zkity/sweetHome/docs/reference/raspberrypi.md

# RaspBerry Pi4

## GPIO

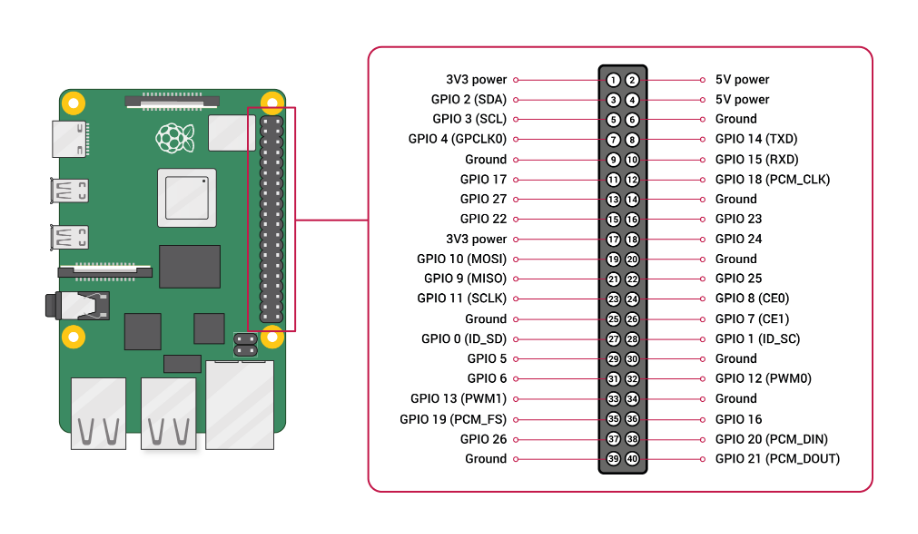
[picture p20: docs/reference/imgs/raspberrypi/2020-05-14-17-41-08.png]


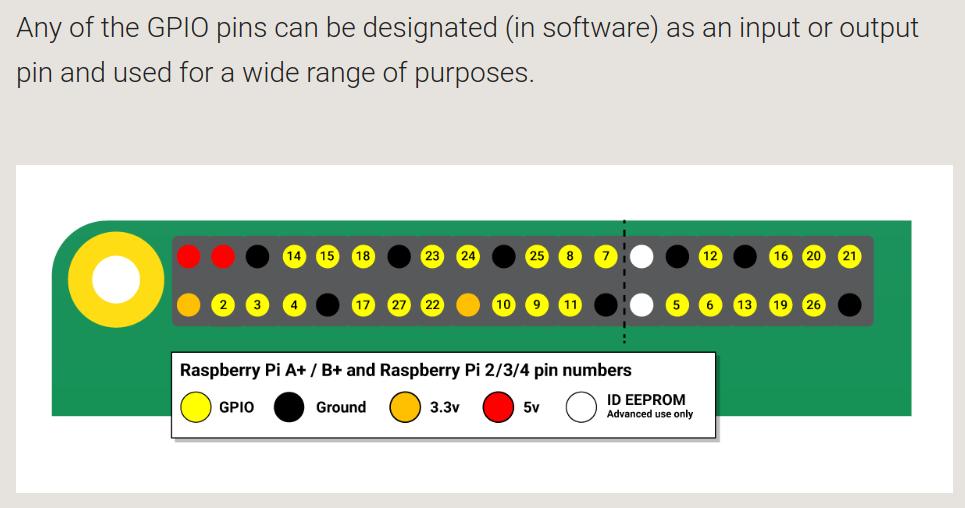
[picture p21: docs/reference/imgs/raspberrypi/2020-05-14-17-41-43.png]


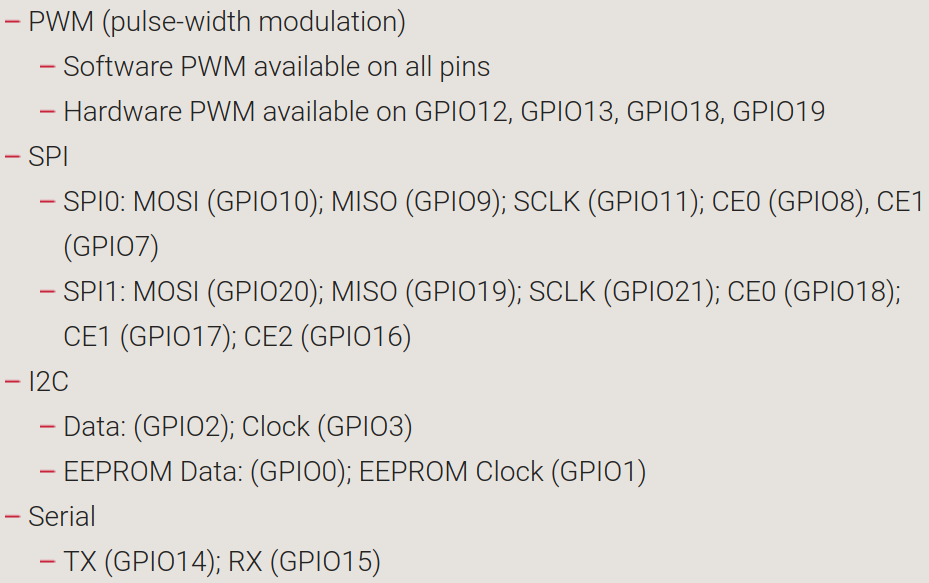
[picture p22: docs/reference/imgs/raspberrypi/2020-05-14-17-42-22.png]


可用pinout查看GPIO使用情况

[串口配置过程](https://blog.csdn.net/ReCclay/article/details/104679944)
