zkity/sweetHome/docs/reference/zigbee.md

# 选用卓万科技的zigbee串口透传模块
该信息来自于卓万科技的开发文档，在此记录方便查阅，若有侵权，请联系我删除。
## 模块硬件信息

### 模块型号

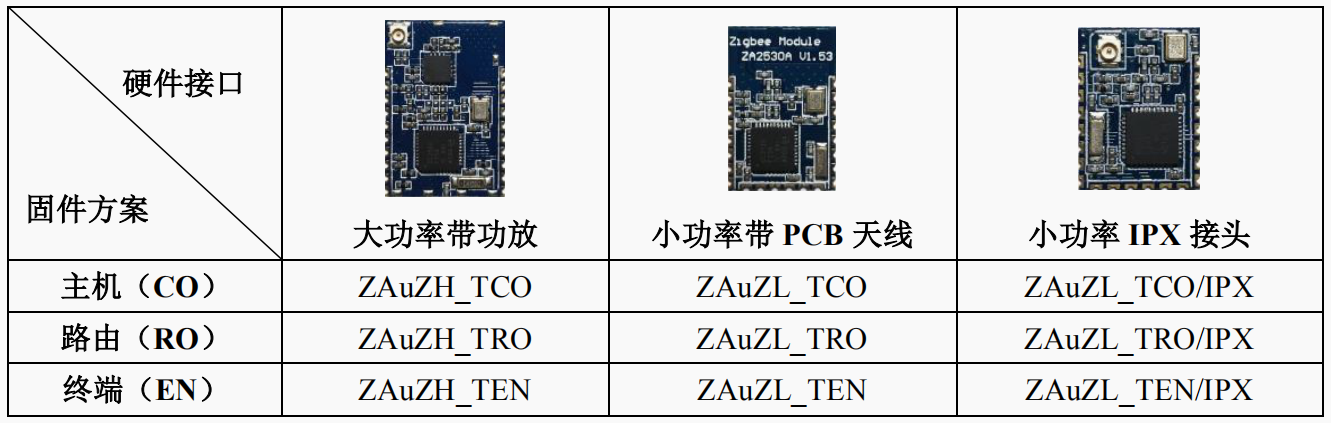
[picture p23: docs/reference/imgs/zigbee/2020-05-14-17-04-22.png]


### 引脚定义

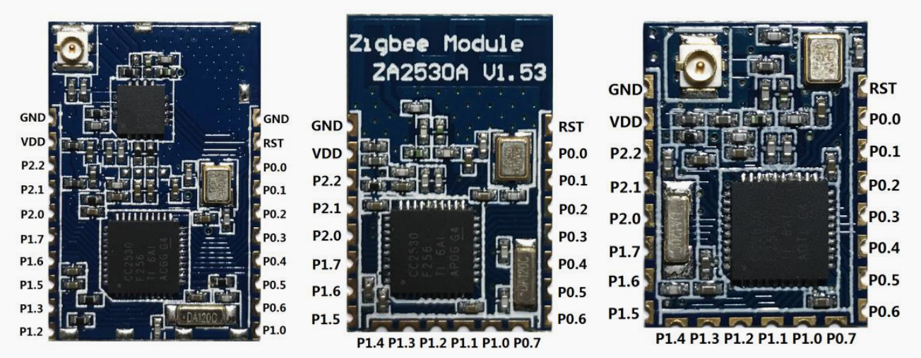
[picture p24: docs/reference/imgs/zigbee/2020-05-14-17-05-11.png]


### 引脚功能

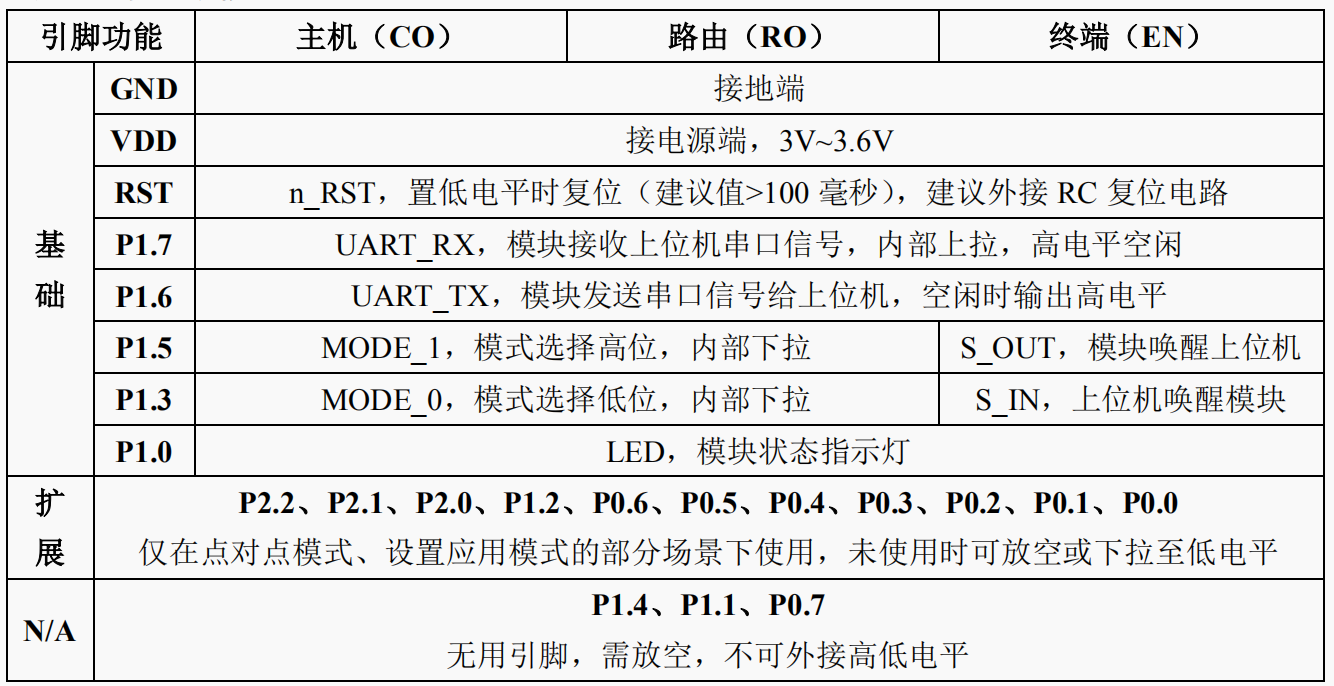
[picture p25: docs/reference/imgs/zigbee/2020-05-14-17-05-27.png]


### 硬件参数

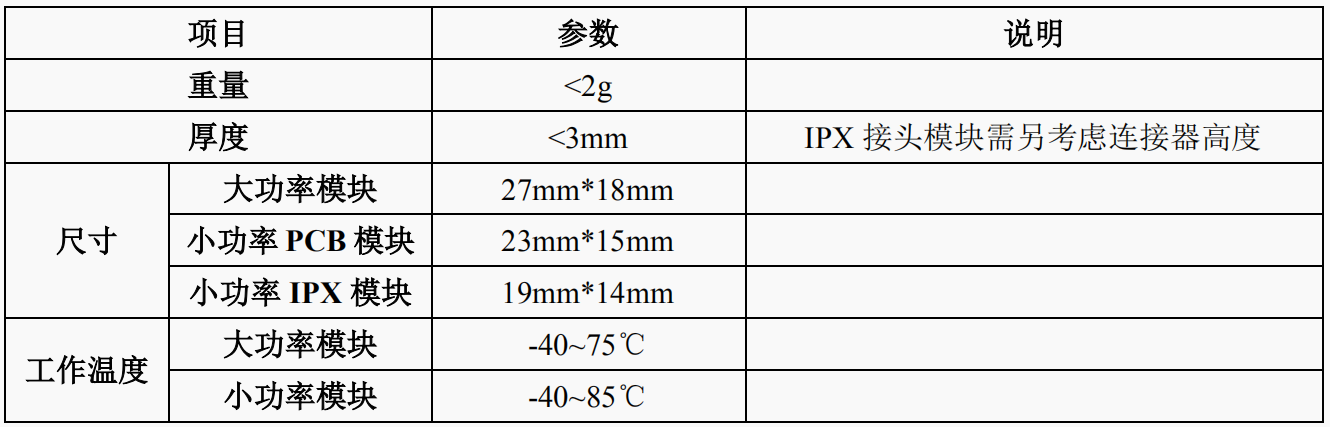
[picture p26: docs/reference/imgs/zigbee/2020-05-14-17-08-48.png]


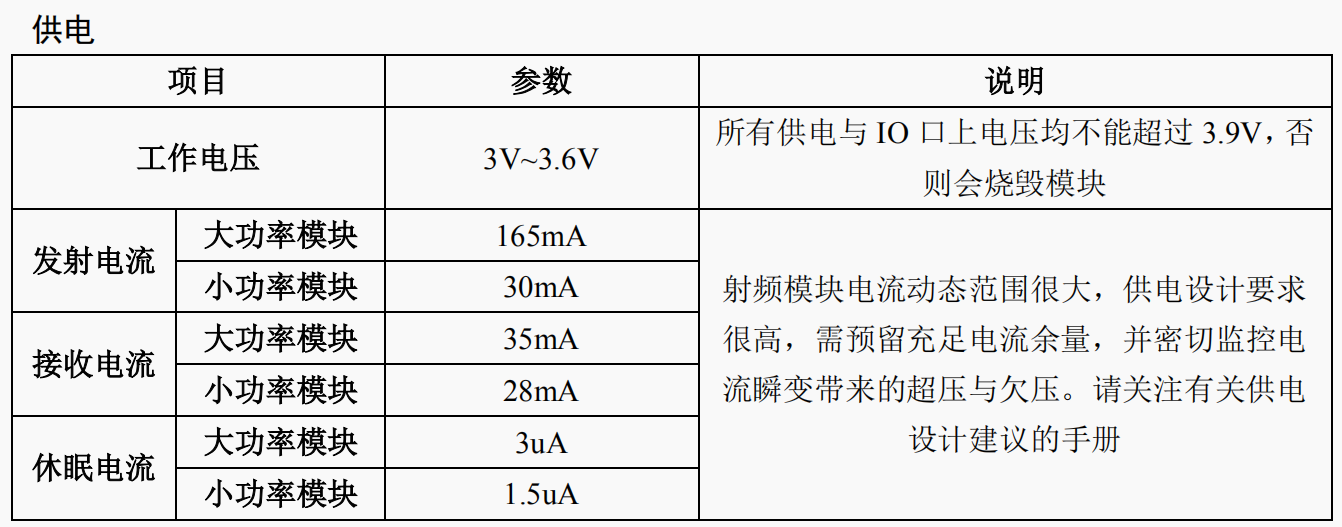
[picture p27: docs/reference/imgs/zigbee/2020-05-14-17-09-00.png]


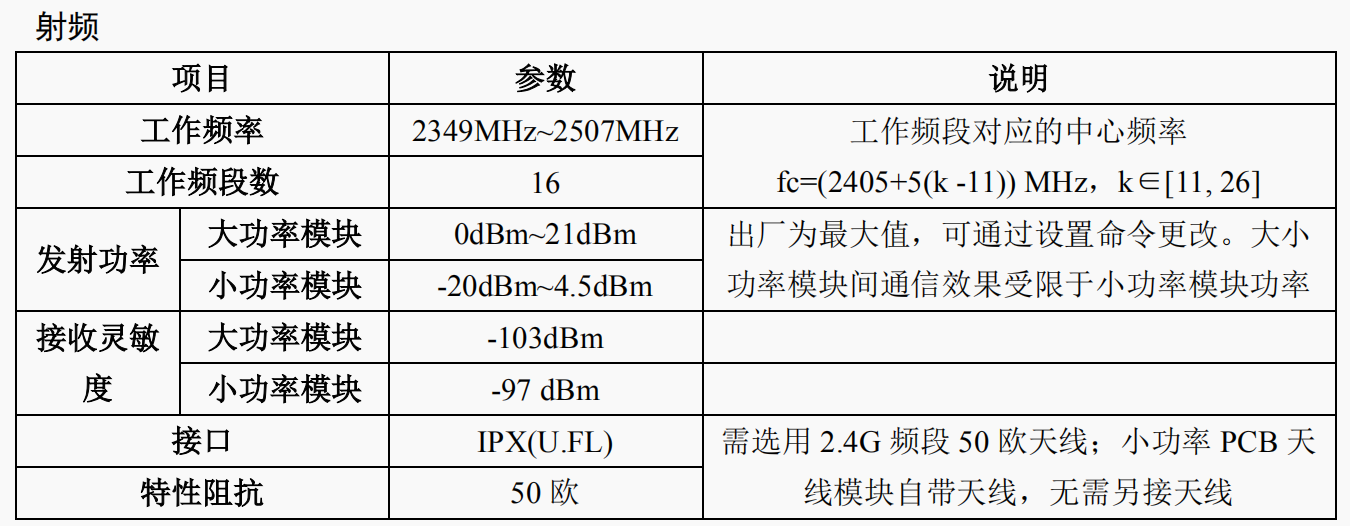
[picture p28: docs/reference/imgs/zigbee/2020-05-14-17-09-13.png]


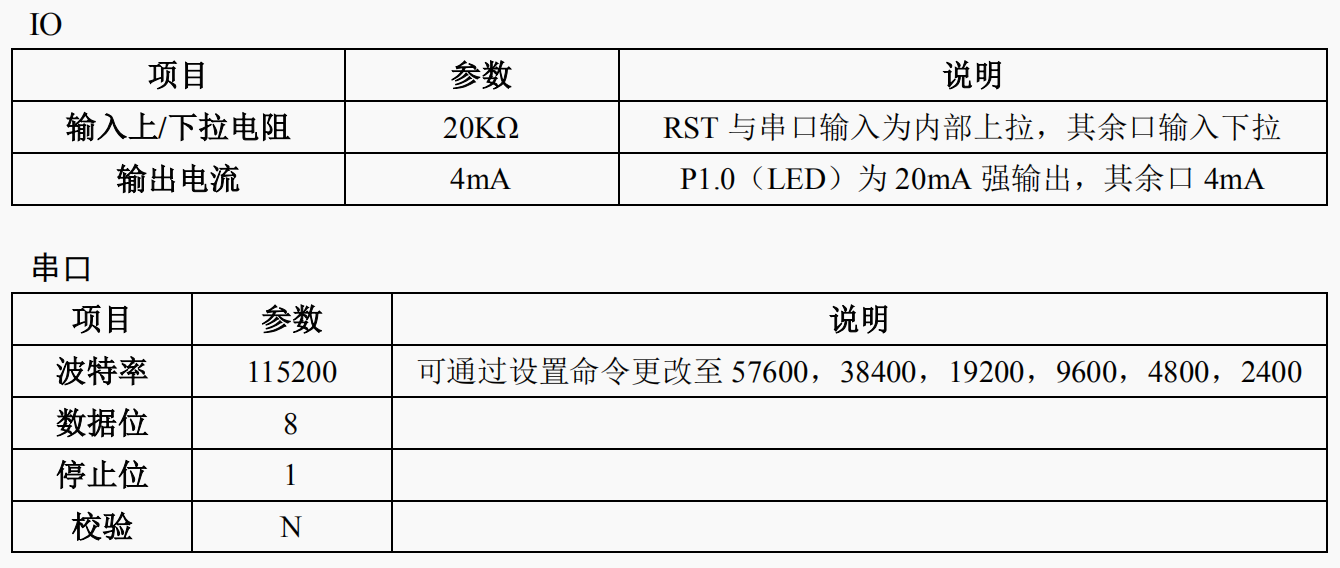
[picture p29: docs/reference/imgs/zigbee/2020-05-14-17-09-26.png]


## 工作模式

分为广播，一对多，点对点模式，这里先采用一对多模式

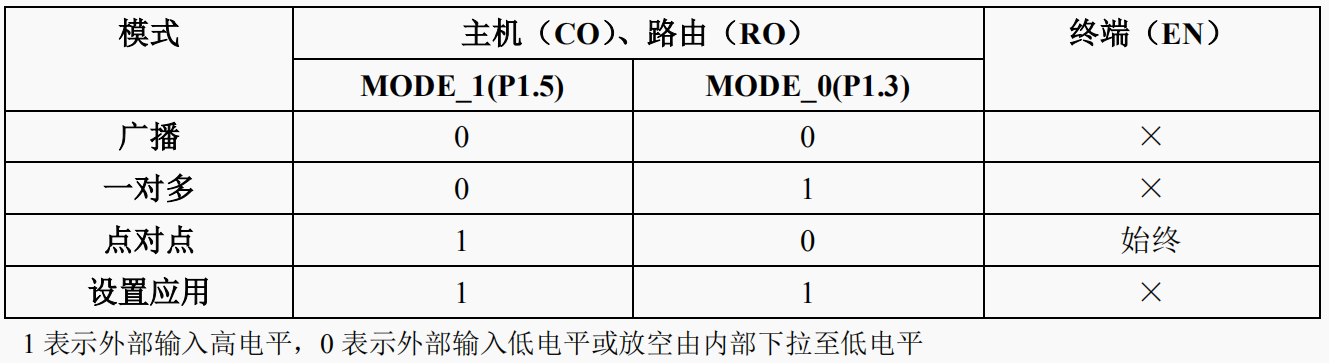
[picture p30: docs/reference/imgs/zigbee/2020-05-14-17-11-24.png]


### 一对多模式

按照如下方式连接

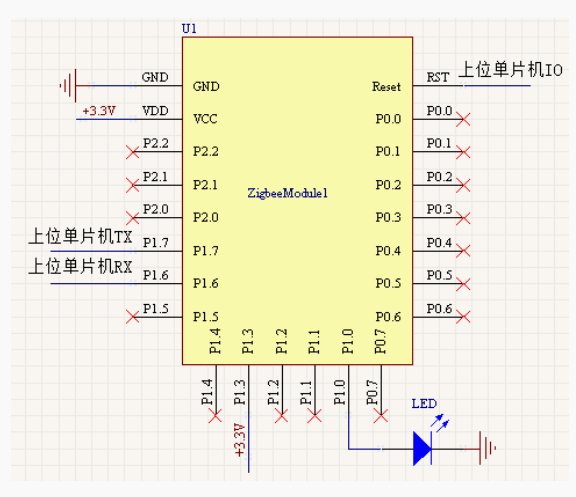
[picture p31: docs/reference/imgs/zigbee/2020-05-14-17-12-12.png]


在该模块的实现里，串口数据都是打包为数据包的形式，已近做了数据包的校验，不会出现字节错误丢失的情况，数据包长度为1-80字节。
