zkity/sweetHome/docs/imgs/documentation/2020-06-24-09-42-55.png

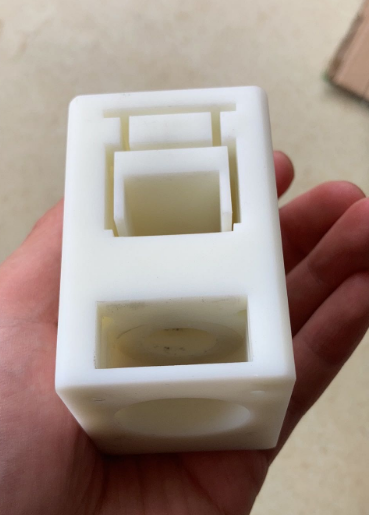
docs/imgs/documentation/2020-06-24-09-42-55.png
