zkity/sweetHome/3d/right_roll.stl

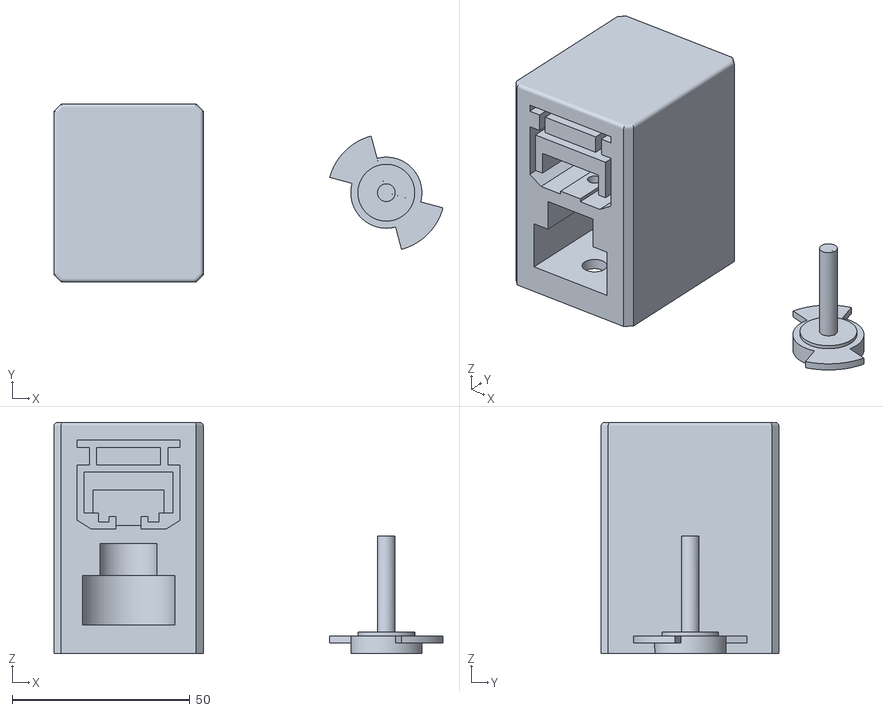
[picture p33: CAD file, 2020-06-26]
3d/right_roll.stl
109.4 x 50.0 x 65.0
