zkity/sweetHome/3d/left_motor.stl

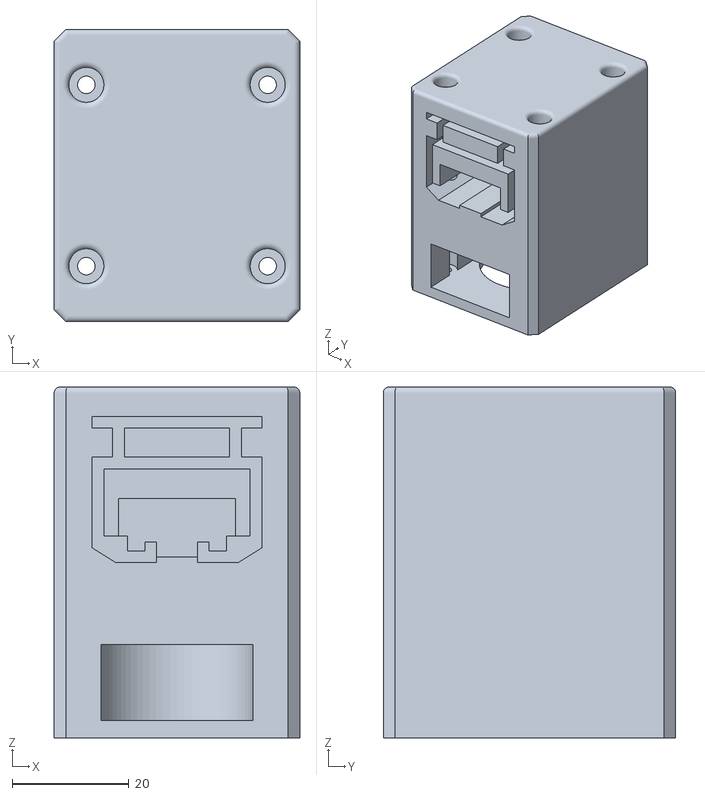
[picture p34: CAD file, 2020-06-26]
3d/left_motor.stl
42.0 x 50.0 x 60.0
