zkity/sweetHome/stm32/light/light.ioc

Mcu.UserName=STM32F103C8Tx
PA1.Signal=ADCx_IN1
PA10.Signal=USART1_RX
PA13.Signal=SYS_JTMS-SWDIO
PA14.Signal=SYS_JTCK-SWCLK
PA2.Signal=ADCx_IN2
PA7.Signal=S_TIM3_CH2
PA9.Signal=USART1_TX
PB0.Signal=S_TIM3_CH3
PB1.Signal=S_TIM3_CH4
PB10.Signal=USART3_TX
PB11.Signal=USART3_RX
PB13.Signal=GPIO_Output
PB15.Signal=GPXTI15
PB3.Signal=GPIO_Output
PB4.Signal=GPIO_Output
PD0-OSC_IN.Signal=RCC_OSC_IN
PD1-OSC_OUT.Signal=RCC_OSC_OUT
