zkity/sweetHome/stm32/light/Core/Src/main.c

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

/* Includes ------------------------------------------------------------------*/
#include "main.h"

/* USER CODE BEGIN Includes */
#include "stdio.h"
#include "math.h"
/* USER CODE END Includes */

/* USER CODE BEGIN PD */

// 用于串口输出到ZigBee的数组的大小
#define UART_ZB_BUF_SIZE 10
// 用于串口输出到Log的数组大小
#define UART_LOG_BUF_SIZE 128

// 声音信号的暂存数组大小
#define VOICE_BUF_SIZE 100
#define VOICE_BUF_PER_SIZE 100

// 存储前ns声音信号的值
#define VOICE_STORE_N 3

// ZigBee 发送数据长度
#define ZB_SEND_DATA_LEN 8
// ZigBee 接收数据长度
#define ZB_RECEIVE_DATA_LEN 5

// 串口输出到ZigBee，DMA方式
#define sendToZBByDMA(...) HAL_UART_Transmit_DMA(&huart1,\
										(uint8_t*)uart_ZB_buf,\
										sprintf(uart_ZB_buf, __VA_ARGS__))
// 串口输出到ZigBee，IT方式
#define sendToZBByIT(...) HAL_UART_Transmit_IT(&huart1,\
										(uint8_t*)uart_ZB_buf,\
										sprintf(uart_ZB_buf, __VA_ARGS__))
// 串口输出到Log，DMA方式
#define sendToLogByDMA(...) HAL_UART_Transmit_DMA(&huart3,\
										(uint8_t*)uart_log_buf,\
										sprintf(uart_log_buf, __VA_ARGS__))
// 串口输出到Log，IT方式
#define sendToLogByIT(...) HAL_UART_Transmit_IT(&huart3,\
										(uint8_t*)uart_log_buf,\
										sprintf(uart_log_buf, __VA_ARGS__))
/* USER CODE END PD */

ADC_HandleTypeDef hadc1;
DMA_HandleTypeDef hdma_adc1;

TIM_HandleTypeDef htim3;

UART_HandleTypeDef huart1;
UART_HandleTypeDef huart3;
DMA_HandleTypeDef hdma_usart1_rx;
DMA_HandleTypeDef hdma_usart1_tx;
DMA_HandleTypeDef hdma_usart3_rx;
DMA_HandleTypeDef hdma_usart3_tx;

/* USER CODE BEGIN PV */

// 设备地址
const char DEVICE_ADDRESS = 'b';
// 设备类型
const char DEVICE_TYPE = 'b';
// 配对码
const char DEVICE_PAIR = 'n';

// 上次执行的命令代码
char cmd_idx = 0;

// 场景模式开关
// 1. 进门灯 2. 声控灯 3. 人体感应灯 4. 离家 5. 定时 6. 自动
char state[6] = {'b'};
uint16_t voice_light_count = 0;
uint8_t voice_light_on = 0;

// ZigBee接收到数据的标志
uint8_t is_ZB_rec = 0;
// ZigBee接收数据缓存
uint8_t ZB_rec_buf[ZB_RECEIVE_DATA_LEN];
// 用于串口输出到ZigBee的数组的大小
char uart_ZB_buf[UART_ZB_BUF_SIZE];
char zb_send[UART_ZB_BUF_SIZE];

// 用于串口输出到Log的数组
char uart_log_buf[UART_LOG_BUF_SIZE];

// 用于ADC转换存储的数组
uint32_t adc_buf[2];

// 用于记录当前1s内采集到的声音信号
uint8_t voice_s[VOICE_BUF_SIZE] = {0};
// 用于记录当前1/200s内采集到的声音信号
uint8_t voice_s_p[VOICE_BUF_PER_SIZE] = {0};
// 上述对应信号容器的索引值
uint8_t voice_s_idx = 0;
uint8_t voice_s_p_idx = 0;

// 用于存储前ns声音信号的最大值
uint8_t voice_t[VOICE_STORE_N] = {0};
uint8_t voice_t_idx = 0;

// 当前信号转换后的值
uint8_t light_current = 0;
uint8_t voice_current = 0;

/* USER CODE END PV */

void SystemClock_Config(void);
static void MX_GPIO_Init(void);
static void MX_DMA_Init(void);
static void MX_ADC1_Init(void);
static void MX_TIM3_Init(void);
static void MX_USART1_UART_Init(void);
static void MX_USART3_UART_Init(void);
/* USER CODE BEGIN PFP */

// 控制全彩LED的函数，细致控制
// 该LED，RGB通道的额定电压为1v8-2v,3v2-3v4,3v2-3v4;最高亮度为1200,5000,3000
// 参数r,g,b取值为0-100,为对应通道的亮度
void setLED(uint8_t r, uint8_t g, uint8_t b){
	float nmbda_h = 0.8;
	float nmbda_r = 0.6;
	float nmbda_g = 0.4;
	float nmbda_b = 0.7;
	TIM3->CCR2 = floor(r*nmbda_h*nmbda_r);
	TIM3->CCR3 = floor(g*nmbda_h*nmbda_g);
	TIM3->CCR4 = floor(b*nmbda_h*nmbda_b);
}

// 按照预定状态控制LED
void setLevLED(uint8_t lev){
	uint8_t r=0,g=0,b=0;
	switch(lev){
		case 0: r=55, g=10, b=10;break;
		case 1: r=10, g=50, b=10;break;
		case 2: r=10, g=10, b=60;break;
		default: r=55, g=10, b=10;
	}
	TIM3->CCR2 = r;
	TIM3->CCR3 = g;
	TIM3->CCR4 = b;
}

// 复制数组
void copyMat(uint8_t *a, uint8_t *b, uint8_t len){
	for(int i = 0; i< len; i++){
		b[i] = a[i];
	}
}


/* USER CODE END PFP */

/**
  * @brief  The application entry point.
  * @retval int
  */
int main(void)
{
  

  /* MCU Configuration--------------------------------------------------------*/

  /* Reset of all peripherals, Initializes the Flash interface and the Systick. */
  HAL_Init();

  /* Configure the system clock */
  SystemClock_Config();

  /* Initialize all configured peripherals */
  MX_GPIO_Init();
  MX_DMA_Init();
  MX_ADC1_Init();
  MX_TIM3_Init();
  MX_USART1_UART_Init();
  MX_USART3_UART_Init();
  /* USER CODE BEGIN 2 */

  sendToLogByDMA("device init success!\n");
  HAL_Delay(20);
  // 开启时钟
  if(HAL_OK != HAL_TIM_Base_Start_IT(&htim3))
	  Error_Handler();

  // 开启全彩LED的PWM引脚
  TIM3->CCR2 = 60;
  TIM3->CCR3 = 40;
  TIM3->CCR4 = 30;
  HAL_TIM_PWM_Start(&htim3, TIM_CHANNEL_2);
  HAL_TIM_PWM_Start(&htim3, TIM_CHANNEL_3);
  HAL_TIM_PWM_Start(&htim3, TIM_CHANNEL_4);
  HAL_Delay(2000);
  TIM3->CCR2 = 30;
  TIM3->CCR3 = 40;
  TIM3->CCR4 = 50;
  // 串口1使用DMA方式循环接收数据
  HAL_UART_Receive_DMA(&huart1,\
		  	  	  	   ZB_rec_buf,\
  					   ZB_RECEIVE_DATA_LEN);
  // 用于处理指令的缓存
  // uint8_t ZB_cache[ZB_RECEIVE_DATA_LEN] = {0};
  /* USER CODE END 2 */
 
 

  /* Infinite loop */
  /* USER CODE BEGIN WHILE */
  uint8_t zb_cache[ZB_RECEIVE_DATA_LEN] = {0};
  while (1)
  {
	  // ZigBee接收到指令
	  if(is_ZB_rec == 1){
		  // 将指令复制到cache
		  copyMat(ZB_rec_buf, zb_cache, ZB_RECEIVE_DATA_LEN);
		  is_ZB_rec = 0;
		  // 若已近处理则抛弃
		  if(zb_cache[1] == cmd_idx){
			  continue;
		  }else{
			  cmd_idx = zb_cache[1];
			  // 处理指令，配对
			  if(zb_cache[2] == 'a'){
				  if((DEVICE_PAIR == zb_cache[3]) && (DEVICE_TYPE == zb_cache[4])){
					  zb_send[2] = 'T';
				  }else{
					  zb_send[2] = 'F';
				  }
				  zb_send[0] = DEVICE_ADDRESS;
				  zb_send[1] = cmd_idx;
				  zb_send[3] = '|';
				  sendToZBByDMA(zb_send);
			  // 处理指令，控制灯的状态
			  }else if(zb_cache[2] == 'b'){
				  if(zb_cache[3] == 'a'){
					  HAL_GPIO_WritePin(GPIOB, GPIO_PIN_13, GPIO_PIN_SET);
					  zb_send[2] = 'T';
				  }else{
					  HAL_GPIO_WritePin(GPIOB, GPIO_PIN_13, GPIO_PIN_RESET);
					  zb_send[2] = 'T';
				  }
				  zb_send[0] = DEVICE_ADDRESS;
				  zb_send[1] = cmd_idx;
				  zb_send[3] = '|';
				  sendToZBByDMA(zb_send);
			  // 处理指令，获取灯的状态
			  }else if(zb_cache[2] == 'c'){
				  GPIO_PinState lightState = HAL_GPIO_ReadPin(GPIOB, GPIO_PIN_13);
				  if(lightState == GPIO_PIN_SET){
					  zb_send[2] = 'a';
				  }else{
					  zb_send[2] = 'b';
				  }
				  zb_send[0] = DEVICE_ADDRESS;
				  zb_send[1] = cmd_idx;
				  zb_send[3] = '|';
				  sendToZBByDMA(zb_send);
			  // 处理指令，调整指示灯状态
			  }else if(zb_cache[2] == 'd'){
				  if(zb_cache[3] == 'a'){
					  setLevLED(0);
				  }else if(zb_cache[3] == 'b'){
					  setLevLED(1);
				  }else if(zb_cache[3] == 'c'){
					  setLevLED(2);
				  }else{
					  setLevLED(0);
				  }
				  zb_send[0] = DEVICE_ADDRESS;
				  zb_send[1] = cmd_idx;
				  zb_send[2] = 'T';
				  zb_send[3] = '|';
				  sendToZBByDMA(zb_send);
			  // 处理指令，调整应用场景
			  }else if(zb_cache[2] == 'e'){
				  if((zb_cache[4] == 'c') && (zb_cache[3] == 'z')){
					  zb_send[0] = DEVICE_ADDRESS;
					  zb_send[1] = cmd_idx;
					  zb_send[2] = state[0];
					  zb_send[3] = state[1];
					  zb_send[4] = state[2];
					  zb_send[5] = state[3];
					  zb_send[6] = state[4];
					  zb_send[7] = state[5];
					  zb_send[8] = '|';
					  sendToZBByDMA(zb_send);
				  }else{
					  if(zb_cache[3] == 'a'){
						  state[0] = zb_cache[4];
					  }else if(zb_cache[3] == 'b'){
						  state[1] = zb_cache[4];
					  }else if(zb_cache[3] == 'c'){
						  state[2] = zb_cache[4];
					  }else if(zb_cache[3] == 'd'){
						  state[3] = zb_cache[4];
					  }else if(zb_cache[3] == 'e'){
						  state[4] = zb_cache[4];
					  }else if(zb_cache[3] == 'f'){
						  state[5] = zb_cache[4];
					  }
					  zb_send[0] = DEVICE_ADDRESS;
					  zb_send[1] = cmd_idx;
					  zb_send[2] = 'T';
					  zb_send[3] = '|';
					  sendToZBByDMA(zb_send);
				  }
			  }
		  }
		  sendToLogByDMA("zb get data! %c, %c, %c, %c, %c\n", ZB_rec_buf[0], ZB_rec_buf[1], ZB_rec_buf[2], ZB_rec_buf[3], ZB_rec_buf[4]);
	  }
    /* USER CODE END WHILE */

    /* USER CODE BEGIN 3 */

	//sendToLogByDMA("v1: %d, v2: %d, v3: %d; v: %d, l: %d\n", voice_t[0], voice_t[1], voice_t[2], voice_current, light_current);
	// sendToZBByDMA("abcde");
	// HAL_Delay(3000);
  }
  /* USER CODE END 3 */
}

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
/* USER CODE BEGIN 4 */

// 光线传感器的值归一化到0-511
uint8_t sensor_light(uint32_t x){
	return (uint8_t)(x*511/4095);
}

// 声音传感器的值归一化到0-511
uint8_t sensor_voice(uint32_t x){
	return (uint8_t)(x*511/2095);
}

// 返回1/100秒内声音的最大值
uint8_t voice_second_per_max(){
	uint8_t vm = 0;
	for(int i=0; i<VOICE_BUF_PER_SIZE; i++){
		if(voice_s_p[i] > vm){
			vm = voice_s_p[i];
		}
	}
	return vm;
}

// 返回1秒内声音的最大值
uint8_t voice_second_max(){
	uint8_t vm = 0;
	for(int i=0; i<VOICE_BUF_SIZE; i++){
		if(voice_s[i] > vm){
			vm = voice_s[i];
		}
	}
	return vm;
}

// 触摸开关控制灯的亮灭
void HAL_GPIO_EXTI_Callback(uint16_t GPIO_Pin)
{
	if(GPIO_Pin == GPIO_PIN_15){
		HAL_GPIO_TogglePin(GPIOB, GPIO_PIN_13);
	}
}

// TIM3定时器中断,100us一次
void HAL_TIM_PeriodElapsedCallback(TIM_HandleTypeDef *htim){
	  // 执行ADC自动自校准
	  if(HAL_OK != HAL_ADCEx_Calibration_Start(&hadc1))
		  Error_Handler();
	  //开启ADC
	  if(HAL_OK != HAL_ADC_Start_DMA(&hadc1, adc_buf, 2))
		  Error_Handler();

	  // 声光控实现
	  if(state[2] == 'a'){
		  if(voice_light_on == 0){
			  if((light_current < 20) && (voice_current > 200)){
				  HAL_GPIO_WritePin(GPIOB, GPIO_PIN_13, GPIO_PIN_SET);
				  voice_light_on = 1;
			  }
		  }else{
			  voice_light_count++;
		  }
		  if(voice_light_count >= 200){
			  HAL_GPIO_WritePin(GPIOB, GPIO_PIN_13, GPIO_PIN_RESET);
			  voice_light_on = 0;
		  }
	  }
}

// ADC转换完成后回调函数
void HAL_ADC_ConvCpltCallback(ADC_HandleTypeDef* hadc){
	if(HAL_OK != HAL_ADC_Stop_DMA(&hadc1))
		Error_Handler();
	light_current = sensor_light(adc_buf[0]);
	voice_current = sensor_voice(adc_buf[1]);

	// 循环填充声音信号暂存数组
		  if(voice_s_p_idx < VOICE_BUF_PER_SIZE){
			  voice_s_p[voice_s_p_idx] = voice_current;
			  voice_s_p_idx++;
		  }else{
			  // 1/100s
			  voice_s_p_idx = 0;

			  if(voice_s_idx < VOICE_BUF_SIZE){
				  voice_s[voice_s_idx] = voice_second_per_max();
				  voice_s_idx++;
			  }else{
				  // 1s
				  voice_s_idx = 0;

				  if(voice_t_idx < VOICE_STORE_N){
					  voice_t[voice_t_idx] = voice_second_max();
					  // sendToLogByDMA("1s!- %d\n", voice_t[voice_t_idx]);
					  voice_t_idx++;
				  }else{
					  // 3s
					  voice_t_idx = 0;
					  // sendToLogByDMA("3s!- %d - %d - %d\n", voice_t[0], voice_t[1], voice_t[2]);
				  }
			  }
		  }
}

// 串口1收到数据的回调函数
void HAL_UART_RxCpltCallback(UART_HandleTypeDef *huart){
	if (huart->Instance == USART1){
		// 若接收方为自己则接收
		if(ZB_rec_buf[0] == DEVICE_ADDRESS){
			is_ZB_rec = 1;
		}
	}
}

/* USER CODE END 4 */
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
