zkity/sweetHome/(commit log)

2020-05-31 add doc sensor stm32
2020-06-02 add sensor test
2020-06-26 add server
    [left_motor.stl, right_roll.stl]
